Shei-Designs/Mosaik/docs/brand/social-preview.png

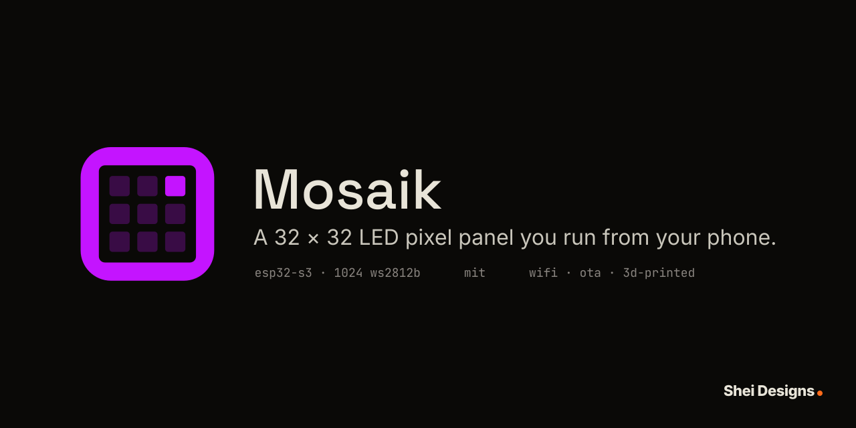
docs/brand/social-preview.png
