Shei-Designs/Mosaik/docs/images/webui-full.png

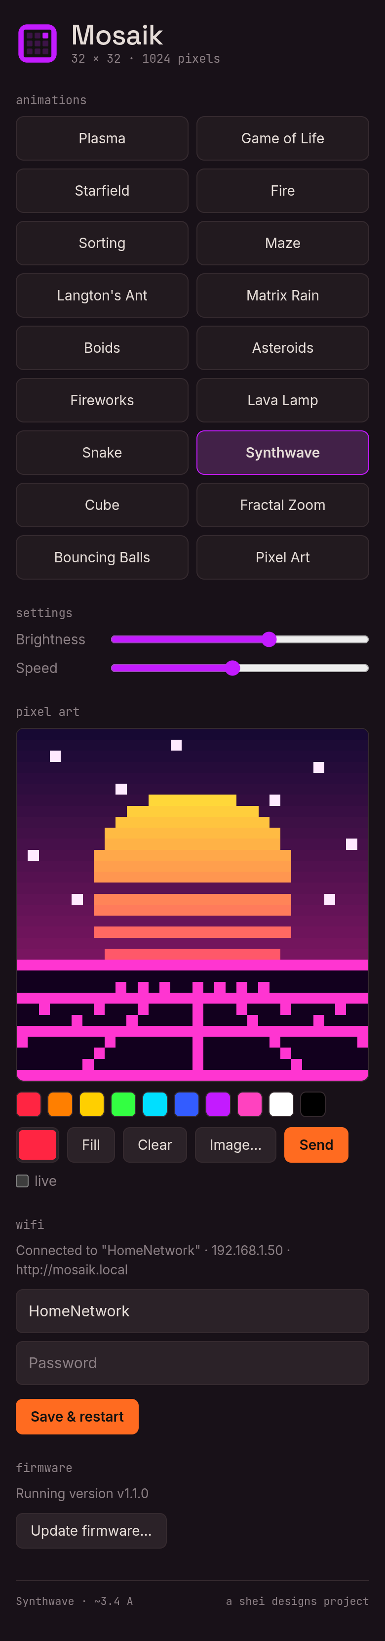
docs/images/webui-full.png
