Shei-Designs/Mosaik/3D_print_assets/Base_B_top_left.stl

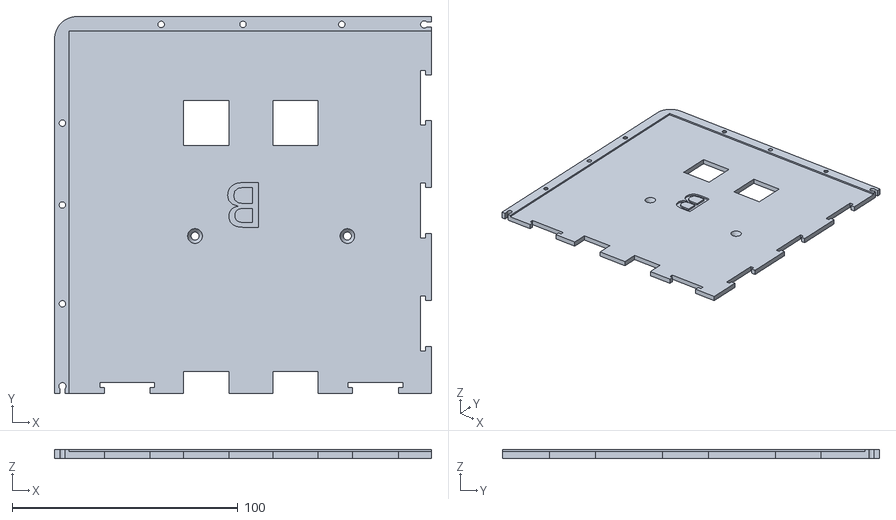
[picture p6: CAD file, 2026-11-07]
3D_print_assets/Base_B_top_left.stl
167.0 x 167.0 x 4.00
