Shei-Designs/Mosaik/3D_print_assets/Wall_Hanger.stl

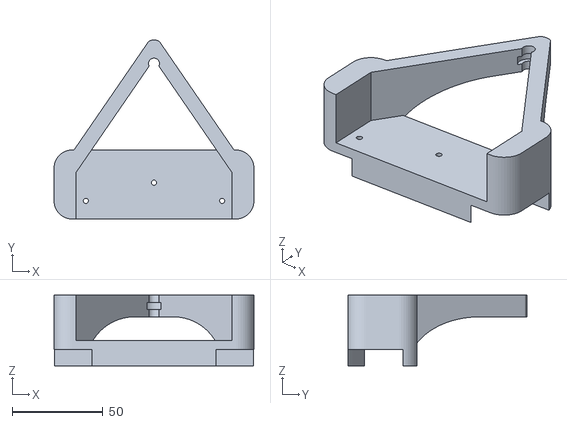
[picture p7: CAD file, 2026-11-07]
3D_print_assets/Wall_Hanger.stl
110.0 x 98.5 x 39.0
