Shei-Designs/Mosaik/3D_print_assets/Cable_Cover_Long.stl

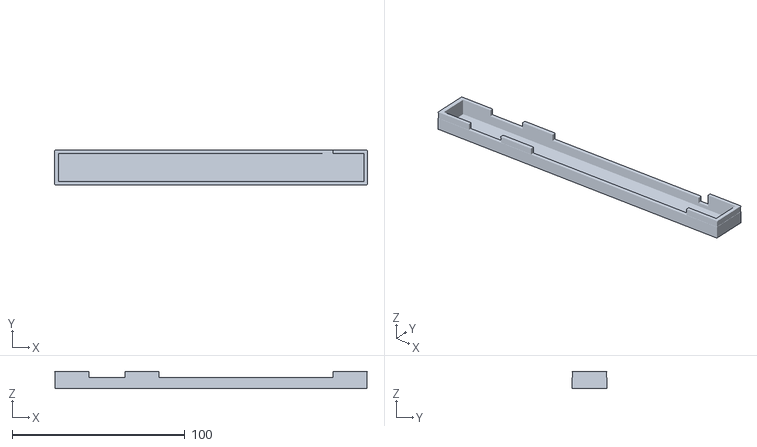
[picture p8: CAD file, 2026-11-07]
3D_print_assets/Cable_Cover_Long.stl
181.3 x 20.2 x 10.00
