Shei-Designs/Mosaik/3D_print_assets/Base_C_top_right.stl

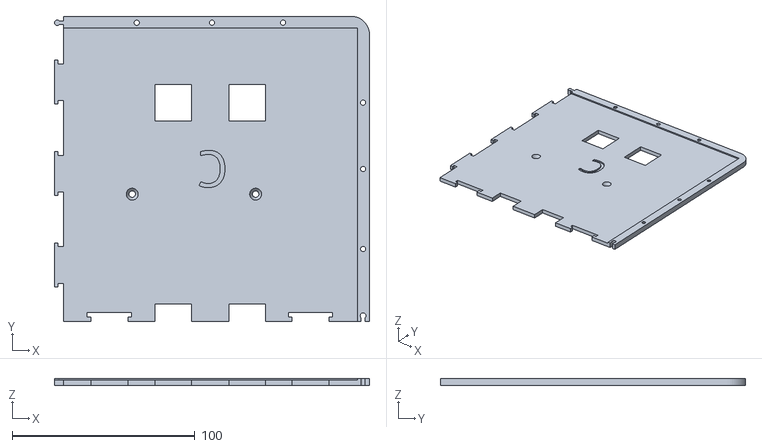
[picture p9: CAD file, 2026-11-07]
3D_print_assets/Base_C_top_right.stl
172.2 x 167.0 x 4.00
