Shei-Designs/Mosaik/3D_print_assets/ESP32_Cover.stl

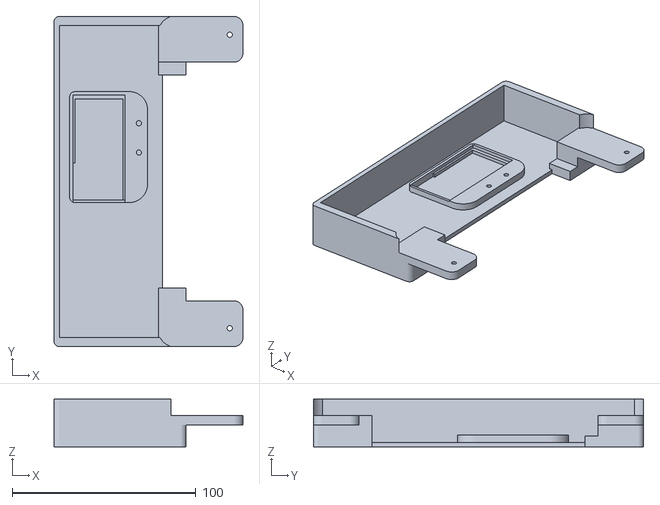
[picture p10: CAD file, 2026-11-07]
3D_print_assets/ESP32_Cover.stl
103.0 x 180.0 x 26.0
