Shei-Designs/Mosaik/3D_print_assets/Diffuser_x4.stl

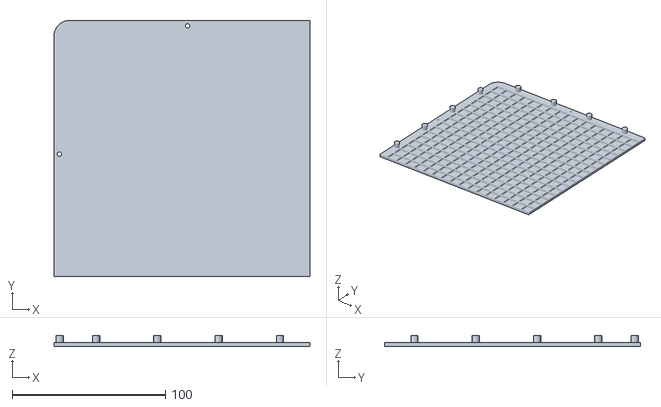
[picture p11: CAD file, 2026-11-07]
3D_print_assets/Diffuser_x4.stl
167.1 x 167.1 x 7.00
