Shei-Designs/Mosaik/3D_print_assets/Cable_Cover_Short_B.stl

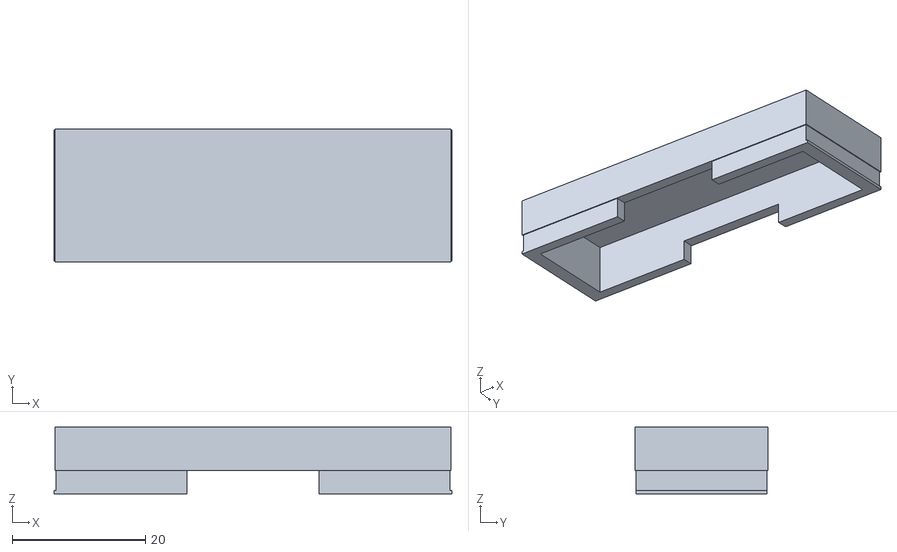
[picture p12: CAD file, 2026-11-07]
3D_print_assets/Cable_Cover_Short_B.stl
59.8 x 20.0 x 10.0
