Shei-Designs/Mosaik/3D_print_assets/Base_D_bottom_right.stl

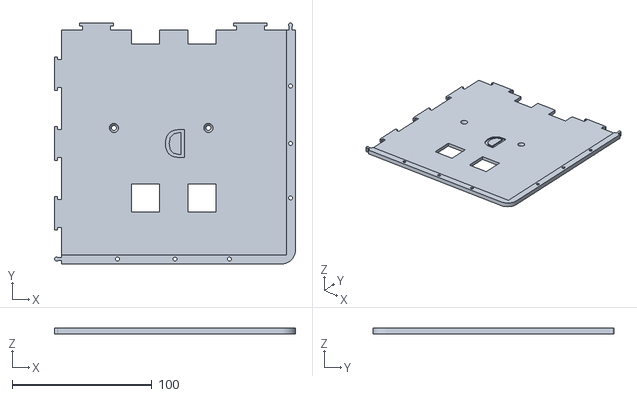
[picture p13: CAD file, 2026-11-07]
3D_print_assets/Base_D_bottom_right.stl
172.2 x 172.2 x 4.00
