Shei-Designs/Mosaik/3D_print_assets/Pixel_Grid_Top_x2.stl

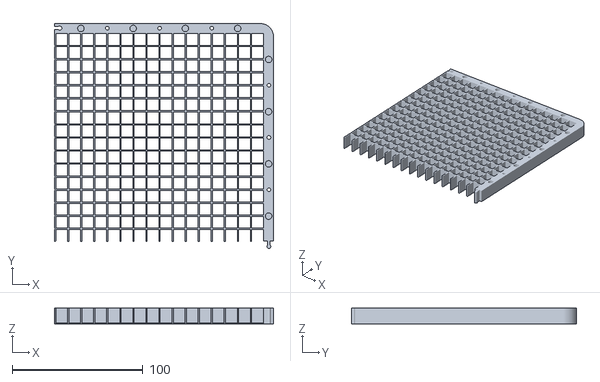
[picture p14: CAD file, 2026-11-07]
3D_print_assets/Pixel_Grid_Top_x2.stl
167.8 x 172.2 x 12.0
