Shei-Designs/Mosaik/3D_print_assets/Back_Plate.stl

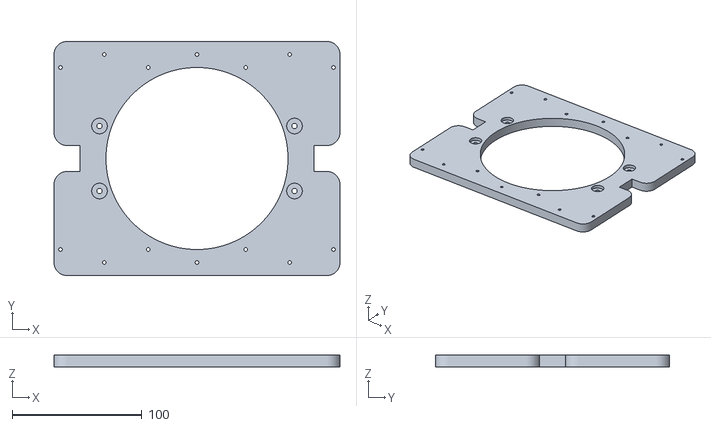
[picture p15: CAD file, 2026-11-07]
3D_print_assets/Back_Plate.stl
220.0 x 180.0 x 9.00
