Shei-Designs/Mosaik/3D_print_assets/Cable_Cover_Short_A.stl

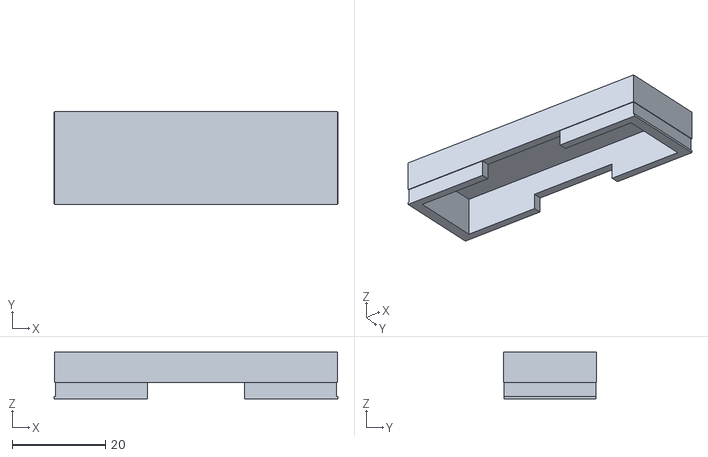
[picture p16: CAD file, 2026-11-07]
3D_print_assets/Cable_Cover_Short_A.stl
60.8 x 20.0 x 10.0
