Shei-Designs/Mosaik/3D_print_assets/ESP32_Clip.stl

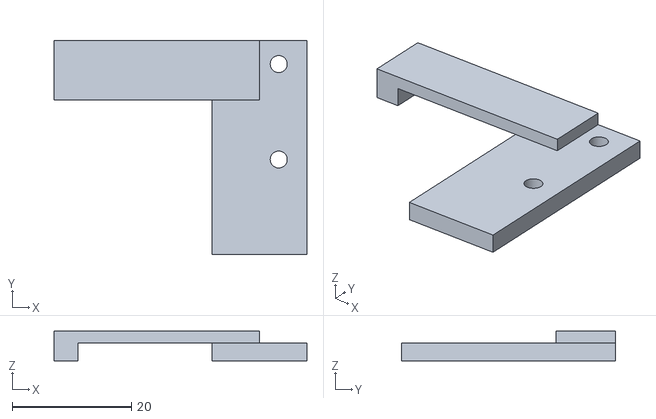
[picture p17: CAD file, 2026-11-07]
3D_print_assets/ESP32_Clip.stl
42.5 x 36.0 x 5.00
