Shei-Designs/Mosaik/3D_print_assets/PSU_Cover.stl

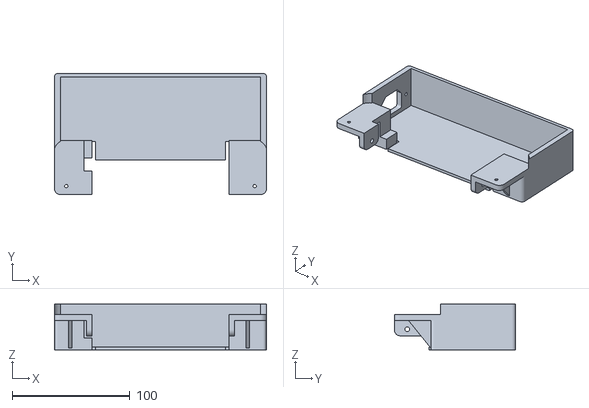
[picture p18: CAD file, 2026-11-07]
3D_print_assets/PSU_Cover.stl
180.0 x 103.0 x 39.0
