Shei-Designs/Mosaik/3D_print_assets/Cable_Cover_Square.stl

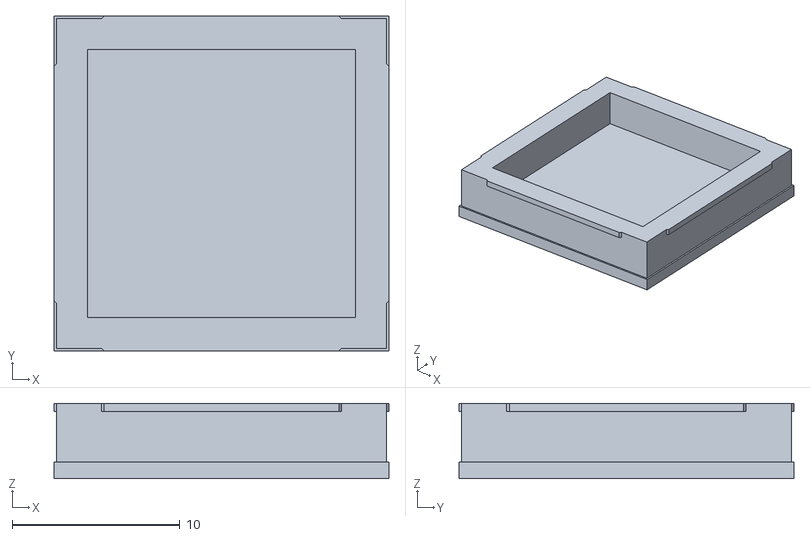
[picture p19: CAD file, 2026-11-07]
3D_print_assets/Cable_Cover_Square.stl
20.0 x 20.0 x 4.50
