Shei-Designs/Mosaik/(list of files, cad)

Other CAD files:
3D_print_assets/Pixel_Grid_Bottom_x2.stl
3D_print_assets/Base_A_bottom_left.stl
