Shei-Designs/Mosaik/(commit log)

2026-07-25 init commit
    [partitions.csv]
2026-07-31 added new modes and OTA
    [partitions.csv]
2026-11-07 Prepare v1.0.0 release: docs, BOM, build guide, STLs, license
    - Add the 3D-printable enclosure parts with descriptive names
    (copy count in the filename where more than one is needed)
    - Add docs/BOM.md and docs/BUILD.md covering parts, fasteners,
    assembly order, mains/5 V wiring and first-time setup
    - Add web UI screenshots (rendered against a mock API) to the README
    - Add MIT license
    - Remove the vendor LED panel datasheet PDF
    - Ignore Playwright output and OS clutter files
    [Back_Plate.stl, Base_A_bottom_left.stl, Base_B_top_left.stl, Base_C_top_right.stl, Base_D_bottom_right.stl, Cable_Cover_Long.stl, Cable_Cover_Short_A.stl, Cable_Cover_Short_B.stl]
